raden-ayu44/embedded-systems/asumsi.md

# Asumsi — Gambar Skematik Housing Grip Load Cell (v5, varian logam)

Dikerjakan satu kali, langsung dari v4 ke v5. Sumber yang dipakai:
- `koreksi_v4.md` (utama);
- bagian `koreksi_v3.md` yang tidak digantikan (spacer PLA terpisah, pelat polos, urutan exploded, kesalahan yang pernah terjadi);
- instruksi pengguna di chat;
- gambar penjual Automa-88 "Loadcell CZL-601, Size & Dimensions", disimpan sebagai `czl601_dimensi_automa88.png`.

Berkas v4 tidak ditimpa. Semua gambar **tidak berskala**, dan celah 2,5 mm digambar diperbesar.

**Pembaruan 11 Okt. 2026 (hanya teks dokumen ini):** hasil ukur load cell (130 × 28 × 21,5 mm), ulir lubang pasang (M6, tembus, bibir kisi Ø8 mm), dan diameter kabel (4 mm) sudah dimasukkan. Ringkasan di Bagian 8. **Gambar SVG v5 belum digambar ulang** dan masih memuat label lama (misalnya kabel Ø5, tinggi load cell 22).

**Pembaruan 12 Okt. 2026 (hanya teks dokumen ini):** gambar yang berlaku sekarang bukan lagi v5, melainkan:
- `potongan_memanjang_v11_logam.svg` dan `kalibrasi_setup_v11_20kg.svg`;
- `exploded_isometrik_v12_logam.svg` (panah stiker beban menunjuk ke arah B; lihat 4.1 dan `koreksi.md`);
- `klem_kabel_tampak_depan_v1.svg` dan `klem_kabel_tampak_kiri_v1.svg` (tampak depan dan potongan A-A di x = 4,2 untuk klem kabel; instruksinya `instruksi_klem_tampak.md`);
- `fusion_parameters_housing_grip.csv` (tidak ada CSV v9 sampai v12).

Berkas v5 di tabel di bawah hanya riwayat. Dokumen ini adalah gabungan: isi asumsi lama (v2, v3, dan v4) sudah dipadatkan ke Bagian 9 dan berkas lama itu dihapus (12 Okt. 2026). Instruksi untuk Cowork ada di `koreksi.md` (juga gabungan). Arah kabel, panah stiker, dan rincian klem di Bagian 4.1 sudah mengikuti gambar-gambar di atas.

| File v5 | Isi |
|---|---|
| `potongan_memanjang_v5_logam.svg` | Potongan memanjang melalui satu baris lubang. Pelat Al 10 polos, Spacer A/B PLA, load cell 130 mm, baut M6 × 25 + washer. Dimensi a = 37, x = 102, spacer 28, bentang bebas 74, lubang 12 dari ujung, 106 antar pasangan |
| `exploded_isometrik_v5_logam.svg` | Urutan dari atas: pelat A → Spacer A → load cell → Spacer B → pelat B. 4 baut pola 2 × 2 (15 melintang, 106 antar pasangan) |
| `kalibrasi_setup_v5.svg` | **Tidak dibuat**, sesuai permintaan (lihat Pertentangan 6) |

## 1. Perubahan dari v4

1. **Load cell diganti** dengan CZL601. Ukuran di gambar penjual 130 × 28 × 22 mm; **terukur 130 × 28 × 21,5 mm (10 Okt. 2026, jangka sorong)**. Ukuran lama 147 × 30 × 22 mm dari load cell 180 kg tidak dipakai lagi. Load cell ditaruh di tengah pelat 170 mm, jadi sisa pelat 20 mm di tiap ujung.
2. **Lubang pasang:** 4 × M6, dua per ujung. Pusat lubang 12 mm dari ujung load cell, 106 mm antar pasangan, dan 15 mm melintang (angka dari gambar penjual, belum diukur). Lubang pelat dan spacer sejajar dengan lubang load cell. Diameter lubang: **Ø6,6 mm di pelat** dan **Ø7,0 mm di spacer PLA** (keputusan 11 Okt. 2026; gambar SVG v5 belum memuat angka ini). **Ulir lubang di load cell terukur M6** (diameter dalam 5,0 dan 5,2 mm; bibir kisi Ø8 mm; tembus lurus), lihat Bagian 8.
3. **Tonjolan dihapus**, dan pelat A/B menjadi **pelat aluminium 10 mm polos** (sudah diputuskan; paduan **6061-T6**, alternatif 5052-H32, keputusan 11 Okt. 2026). Counterbore v4 juga dihapus, karena pelat polos tidak difrais.
4. **Spacer PLA terpisah:**
   - Spacer A dan Spacer B, masing-masing 28 × 28 × 2,5 mm, menutup kedua lubang di ujungnya.
   - Callout 4 = Spacer A, callout 5 = Spacer B. Nomor callout lain tetap. Arsirannya dibedakan dari aluminium dan load cell.
5. **Baut:** M6 × 25 + washer logam, 4 buah, langsung masuk ulir load cell tanpa mur. Kepala dan washer menonjol di luar pelat (lihat 3.3).
6. **Geometri turunan (boss_L = 28):** lengan tuas a = 37 mm, ujung jauh x = 102 mm, bentang bebas 74 mm. Nilai lama 60/133 (v4) dan 43,5/117/30/87 (`koreksi_v3.md`) tidak dipakai.
7. **Zona genggam ≈85 mm**, sebelumnya ≈90 di v4. Zona ini lebih panjang daripada bentang bebas 74 mm, jadi sebagian beban jatuh di atas spacer. Model beban terpusat di tengah tetap dipakai dan konservatif untuk momen.
8. **Area tengah load cell** yang berarsir di gambar penjual digambar sebagai area tengah/penutup sebagai area tengah/penutup (callout 17). Tinggi penutup di atas permukaan diasumsikan 1,0 mm (asumsi desain, 11 Okt. 2026; ukur pada load cell sungguhan).
9. **Lubang binokular** digambar sebagai dua lubang bulat yang disambung celah, mengikuti bentuk di gambar penjual. Ukurannya skematik, tanpa angka.
10. **Kabel:** panjang kabel CZL601 belum diketahui, jadi gambar dan legenda tidak memuat angka panjang kabel. Keputusan 11 Okt. 2026: panjang kabel dipakai ≈28 cm (listing penjual; asumsi desain), lihat 4.1.
11. **Tetap sama:** celah 2,5 mm sebagai celah bebas-sentuh, tebal total 51,5 mm, ridge dan bidang tumpu di sisi luar B, klip kabel menyatu dengan Spacer A, arah beban remasan, jalur gaya tunggal, dan catatan "Stop overload belum dirancang".
12. **Diameter kabel load cell = 4 mm (dilaporkan pengguna, 11 Okt. 2026)**, menggantikan asumsi kerja 5 mm di revisi v5 sebelumnya. Cocok dengan dokumen distributor (4 mm). Yang terdampak (rincian di bagian 4.1):
    - penjepit kabel di batang A: lubang ≈ Ø kabel (4 mm), lebar dan tinggi penjepit menyesuaikan;
    - lengkungan sisa kabel di dekat penjepit: radius tekuk 10 mm (asumsi desain, revisi 11 Okt. malam, lihat 4.1);
    - tempat kabel keluar dari ujung load cell ke penjepit.

    ⚠ Gambar SVG v5 masih berlabel "kabel Ø5 (asumsi kerja, belum diukur)" dan penjepit ≈9 mm. Keduanya belum diperbarui. Angka lain tidak berubah.

## 2. Hitungan kekakuan

### Model
- **Model:** sama dengan model v4 (lihat Bagian 9). Kantilever, F = 686 N (70 kgf), lebar pelat b = 30 mm, I = b·h³/12, E aluminium 70 GPa.
- **Beban:** terpusat di tengah load cell.
- **Geometri:** a = 130/2 − boss_L, x = 130 − boss_L.
- **Rumus:**
  - δ(a) = F·a³ / (3EI)
  - δ(x) = F·a²(3x − a) / (6EI)
  - σ = F·a·(h/2) / I
  - σ_net = σ·b / (b − 2d)
- **Keterbatasan:**
  - Spacer dan baut dianggap kaku.
  - Lenturan load cell sendiri, tinggi penutup, dan margin rakit tidak termasuk.
  - σ_net konservatif, karena lubang berada 16 mm di dalam spacer (12 mm dari ujung), bukan di tepi dalam spacer tempat momen terbesar.
  - Ini hitungan kasar untuk arah desain, bukan verifikasi.

### 2.1 Hasil (dihitung ulang) dan perbandingan dengan tabel `koreksi_v4.md` bagian E

| Pelat | boss_L | a / x | δ titik beban | δ ujung jauh | Sisa celah 2,5* | σ pangkal | σ_net Ø5,5 / Ø6,5 |
|---|---|---|---|---|---|---|---|
| **Al 10 mm (digambar)** | **28** | **37 / 102** | **0,066 mm** | **0,241 mm** | **≥ 2,26 mm** | **50,8 MPa** | **80 / 90 MPa** |
| Al 8 mm (pembanding) | 28 | 37 / 102 | 0,129 mm | 0,470 mm | ≥ 2,03 mm | 79,3 MPa | 125 / 140 MPa |
| Al 10 mm | 24 | 41 / 106 | 0,090 mm | 0,304 mm | ≥ 2,20 mm | 56,3 MPa | 89 / 99 MPa |
| Al 8 mm (pembanding) | 24 | 41 / 106 | 0,176 mm | 0,594 mm | ≥ 1,91 mm | 87,9 MPa | 139 / 155 MPa |

\* Sisa celah = 2,5 mm dikurangi lenturan ujung jauh saja.

Aluminium 8 mm hanya pembanding dan tidak digambar.

**Selisih lebih dari 2% terhadap tabel acuan:**

| Sel | Acuan | Hitungan ini | Selisih | Sebab |
|---|---|---|---|---|
| Al 10 / boss 28, δ titik beban | 0,07 mm | 0,066 mm | −5,4% | **Pembulatan.** 0,0662 dibulatkan ke 2 desimal menjadi 0,07. Dengan 3 desimal nilainya 0,066. Tidak ada beda model. |
| Al 8 / boss 24, δ titik beban | 0,16 mm | 0,176 mm | +9,9% | **Nilai acuan tidak konsisten**, bukan pembulatan. Dengan a dan E yang sama, rasio Al 8 terhadap Al 10 harus (10/8)³ = 1,95. Hitungannya 0,090 × 1,95 = 0,176. Nilai 0,16 hanya keluar bila a ≈ 39,7 mm. Kemungkinan salah hitung atau salah ketik di acuan. Kolom lain di baris yang sama (δ ujung jauh 0,59, σ 88) cocok dengan a = 41. |

Semua sel lain berselisih ≤ 1,4%. Tabel lama di `koreksi_v3.md` (a = 43,5, x = 117) sudah digantikan dan tidak dipakai.

### 2.2 Apakah celah 2,5 mm terlampaui di bawah beban?
- **Al 10 mm (digambar):** lenturan ujung jauh 0,24 mm (boss 28) sampai 0,30 mm (boss 24). **Celah tidak terlampaui** oleh lenturan pelat. Setelah anggaran celah 2.3, sisa celah ≈0,46 mm (boss 28) dan ≈0,40 mm (boss 24).
- **Dibanding v4:** lenturan ujung jauh turun dari 0,80 mm menjadi 0,24 mm. Penyebabnya, a turun dari 60 ke 37 mm berkat spacer 28 mm, padahal v4 memakai tonjolan ≈13,5 mm dengan load cell 147 mm.

### 2.3 Anggaran celah (Al 10, boss 28)

| Komponen | Nilai |
|---|---|
| Lenturan ujung jauh pelat | 0,24 mm |
| Lenturan load cell sendiri pada 70 kgf | 0,5 mm (asumsi desain; belum diukur) |
| Tinggi penutup/area tengah di atas permukaan | 1,0 mm (asumsi desain) |
| Margin rakit (kerataan pelat, spacer, baut) | 0,3 mm (asumsi desain) |
| **Total terpakai** | **2,04 mm** |
| **Sisa dari celah 2,5 mm** | **≈0,46 mm** (boss 24: lenturan 0,30, sisa ≈0,40 mm) |

### 2.4 Catatan Ø lubang
Keputusan 11 Okt. 2026: **lubang pelat Ø6,6 mm** (lubang lewat M6 seri sedang, ISO 273) dan **lubang spacer Ø7,0 mm** (Ø pelat + 0,4). Kasus Ø5,5 dihitung sesuai instruksi awal, tetapi **tidak mungkin dipakai sebagai lubang lewat baut M6**, karena diameter nominal ulir M6 = 6 mm. Kasus Ø6,5 lebih realistis. Sebagai pembanding, lubang lewat M6 menurut ISO 273 biasanya 6,4 / 6,6 / 7,0 mm. Dengan Ø6,6, σ_net Al 10 / boss 28 ≈ 91 MPa (Al 8 / boss 28 ≈ 142 MPa; Al 10 / boss 24 ≈ 101 MPa; Al 8 / boss 24 ≈ 157 MPa). Paduan 6061-T6 punya luluh minimum ≈240 MPa, jadi faktor keamanan ≈2,6 (91 MPa) dan ≈2,4 (101 MPa). Ø lubang pelat **6,6 mm**, ulir load cell terukur M6.

## 3. Pemeriksaan spacer PLA dan baut

### 3.1 Kompresi spacer (E PLA ≈3 GPa, F = 686 N, tebal 2,5 mm)

| Kasus | Luas bersih | Kompresi | Tekanan rata-rata |
|---|---|---|---|
| Geometri v5: 28 × 28, **2 lubang** Ø6,5 per spacer | 717,6 mm² | 0,0008 mm | 0,96 MPa |
| Sesuai teks instruksi: 28 × 28, 4 lubang Ø6,5 | 651,3 mm² | 0,0009 mm | 1,05 MPa |
| Lama (`koreksi_v3.md`): 30 × 30, 4 lubang | 767 mm² | 0,0007 mm (dibulatkan "≈0,001") | — |

Kompresi spacer dapat diabaikan terhadap celah 2,5 mm di semua kasus. Tiap spacer hanya menutup dua lubang (lihat Pertentangan 4).

### 3.2 Tekanan tepi spacer
- **Metode lama** (seluruh momen ditahan kontak spacer, penampang utuh, tanpa preload):
  - M = F·a = 686 × 37 = 25 382 N·mm.
  - S = 28·28²/6 = 3 659 mm³.
  - **M/S ≈ 6,9 MPa** (lama 6,6 MPa dengan a = 43,5 dan spacer 30 × 30).
  - Ditambah tekanan rata-rata ≈1 MPa, tekanan tepi maksimum **≈7,9 MPa**.
- ⚠ **Keterbatasan metode itu:** baut hanya ada 12 mm dari ujung, yaitu 16 mm dari tepi dalam spacer. Tanpa preload yang cukup, pelat cenderung berungkit di tepi dalam spacer:
  - tarik baut per ujung ≈ F·a / 16 ≈ 1,6 kN (≈0,8 kN per baut);
  - gaya kontak di tepi dalam ≈ F·(a + 16) / 16 ≈ 2,3 kN, terpusat di dekat tepi;
  - tekanan lokalnya bergantung pada lebar kontak (asumsi kerja ≈5 mm, jadi ≈2,3 kN / (28 × 5) ≈ 16 MPa) dan bisa jauh di atas 7,9 MPa. Preload baut menahan ini (lihat di bawah).
- **Kesimpulan 3.2:** angka 6,9–7,9 MPa hanya berlaku bila preload baut cukup untuk menjaga seluruh permukaan spacer tetap tertekan. Torsi baut **3 N·m** (asumsi desain, di bawah batas baut kelas 8.8) → preload T = K·d·F dengan K = 0,2, jadi F ≈ 3 / (0,2 × 0,006) ≈ **2,5 kN per baut**. Tekanan rata-rata spacer ≈7 MPa dan tepi ≈14 MPa, di bawah kisaran tekan PLA ≈50 MPa tetapi rawan creep.
- **Risiko PLA:** creep/relaksasi preload. Washer logam di bawah kepala baut mengurangi tekanan di bawah kepala. Washer tidak mencegah creep spacer itu sendiri, jadi perlu cek ulang torsi setelah beberapa kali pakai (prosedur: kencangkan ulang 3 N·m sebelum tiap sesi kalibrasi dan setelah 10 sesi; beri tanda cat pada kepala baut untuk melihat bila longgar).

### 3.3 Panjang baut M6 × 25
- **Panjang ulir masuk:** 25 − washer (1,6 mm, ISO 7089 untuk M6) − pelat 10 − spacer 2,5 ≈ **10,9 mm**.
- **Ujung baut tidak menembus** permukaan seberang load cell (tinggi terukur 21,5 mm).
- **Lubang tembus** (diukur 11 Okt. 2026: berulir, tembus lurus), jadi baut tidak mentok di dasar lubang. Kedalaman ulir efektif sama dengan tinggi load cell.
- **Kecukupan ulir:** ≈10,9 mm ≈ 1,8 × d. Ulir ada sepanjang 21,5 mm, jadi masuk 10,9 mm masih jauh di bawah panjang ulir yang tersedia.
- **Kepala baut dan washer** menonjol di luar pelat A (ujung tetap) dan pelat B (ujung bebas), 32 mm dari ujung pelat. Posisinya **di luar zona genggam** (42,5–127,5 mm). Ketebalan lokal di ujung bertambah setinggi washer + kepala (baut kepala segi enam ISO 4017 M6 × 25 kelas 8.8 dengan washer ISO 7089; tonjolan ≈5,6 mm). Tebal total pelat–load cell = 10 + 2,5 + 21,5 + 2,5 + 10 + ridge 5 = 51,5 mm (Al 8 mm ≈ 47,5 mm); kepala baut belum termasuk.

### 3.4 Lebar dan panjang spacer
- **Lebar:** spacer 28 mm. Lebar load cell terukur 28 mm (10 Okt. 2026), jadi spacer selaras dengan lebar load cell. (Sebelumnya, bila load cell 30 mm, spacer lebih sempit 1 mm per sisi, tetapi tetap menutup kedua lubang: pusat ±7,5 mm + jari-jari 3,3 mm = 10,8 mm < 14 mm.)
- **Panjang:** spacer 28 mm tidak boleh melewati blok ujung ke area tengah. Panjang blok ujung ≈27–28 mm hanya taksiran dari skala gambar penjual, jadi **ukur**. Bila blok hanya 27 mm, spacer 28 mm menumpang 1 mm di area tengah. Kasus boss_L = 24 mm sudah dihitung dan tetap lolos (2.1).

## 4. Catatan lain
- **Kapasitas load cell:** judul `koreksi_v4.md` menyebut CZL601 **80 kg**, sehingga 70 kgf (batas atas S1) = **87,5% dari kapasitas**.
  - Spesifikasi lama (2,0 mV/V, safe overload 150%, panjang kabel, dan seterusnya) milik load cell 180 kg dan **tidak berlaku lagi**. Nilai desain dari datasheet DS-LC1: overload aman 120% (96 kgf) dan merusak 150% (120 kgf).
  - Karena stop overload belum dirancang, remasan di atas ≈80 kg tidak terlindungi. Ini perlu dipertimbangkan bersama batas overload dari datasheet.
- **Massa B:** pelat B Al 10 mm ≈138 g di ujung bebas, jauh di atas tolerance ±36 g di S1. Tare dan pengukuran harus dilakukan pada orientasi yang sama.
- **Grip hibrida:** pelat logam (potong dan bor di bengkel) + spacer dan penjepit PLA. Baut tidak masuk ke PLA, tetapi menembus spacer PLA yang ikut terjepit.

### 4.1 Kabel: diameter 4 mm (dilaporkan pengguna, 11 Okt. 2026)
- **Diameter kabel:** 4 mm, menggantikan asumsi kerja 5 mm dari revisi v5 sebelumnya. Cocok dengan dokumen distributor (4 mm). Alat ukur dan jumlah pengukuran tidak dicatat; ukur ulang dengan jangka sorong bila perlu.
- **Klip kabel (revisi 11 Okt. malam: menyatu dengan Spacer A):**
  - Klip tidak lagi ditempel ke pelat aluminium. Spacer A dicetak satu bagian dengan rak 2,5 mm (≈16 mm sepanjang batang, menjulur 10 mm melewati sisi load cell, ≈9 mm melewati tepi pelat A) dan blok penjepit; semuanya terjepit oleh baut (asumsi desain).
  - Blok: lebar 8,2 mm (sepanjang batang), tebal 8 mm ke arah luar (mulai 1 mm dari sisi load cell), tinggi ≈17,4 mm dari permukaan pelat A. Lubang kabel **Ø4,1 mm** (Ø kabel + 0,1), sumbu 13,25 mm di atas permukaan A dan 4,2 mm dari ujung load cell, segaris dengan lubang Ø5 di load cell. Dinding ≈2,05 mm di kiri dan kanan lubang.
  - **Dinding atas dan bawah lubang (12 Okt. 2026, dari potongan A-A di x = 4,2):** 2,1 mm ke arah B (17,4 − 13,25 − 2,05) dan 11,2 mm ke arah A (13,25 − 2,05, diukur dari muka pelat A, termasuk rak 2,5). Tampak depan dan tampak kiri: `klem_kabel_tampak_depan_v1.svg` dan `klem_kabel_tampak_kiri_v1.svg`.
  - Kabel direkat **lem tembak** di lubang. Epoksi tidak dipakai (tidak tersedia), dan pengikat kabel dibatalkan. Celah kabel Ø4 ke lubang Ø5 load cell = 0,5 mm per sisi.
  - Jarak bebas blok ke pelat B ≈9 mm (26,5 − 17,4 = 9,1). Blok 20–28 mm dari ujung pelat, di luar zona genggam (mulai 42,5 mm). Bagian sisi A saja.
- **Tempat kabel keluar (terukur 11 Okt. 2026, menggantikan asumsi muka ujung):**
  - Kabel keluar **menyamping** dari muka samping panjang load cell (130 × 21,5 mm), di dekat ujung berkabel, di tengah tinggi (10,75 mm dari muka atas dan bawah, jadi 13,25 mm di atas permukaan pelat A).
  - Lubang kabel Ø5 mm; kabel Ø4 mm agak longgar. Tepi lubang ke arah tengah 6,7 mm dari ujung load cell, jadi pusat lubang 4,2 mm dari ujung dan dinding ke muka ujung 1,7 mm. Titik keluar 24,2 mm dari ujung pelat, di luar zona genggam (mulai 42,5 mm).
  - **Kedalaman lubang Ø5 ke arah dalam ≈14 mm (asumsi, belum terukur;** nilai sementara LC_W / 2 di Fusion dan di tampak kiri; ukur dengan batang kawat atau kedalaman jangka sorong).
  - Ø4 mm lebih besar daripada celah 2,5 mm, tetapi kabel keluar di tengah tinggi di antara kedua pelat dan di samping spacer, jadi tidak lewat celah A–LC atau B–LC.
  - Ujung berkabel dijadikan ujung tetap (A).
  - **Panah beban di muka ujung bebas menunjuk ke arah B** (searah tebal 21,5, dengan A di atas), sesuai stiker pada benda asli (dikoreksi pengguna 12 Okt. 2026; digambar di `exploded_isometrik_v12_logam.svg`). Gaya tekan sebenarnya (B menekan ke arah A) berlawanan dengan panah, jadi pembacaan bertanda negatif bila skala tidak dibalik. Protokol kalibrasi sudah mengizinkan kemiringan skala negatif; tandanya diatur di firmware. Arah panah pada benda nyata masih perlu dicek ulang.
- **Lengkungan kabel setelah blok (asumsi desain):**
  - Kabel keluar lurus menyamping dari lubang Ø5 lewat blok, lalu melengkung bebas **ke arah B (ke bawah bila A di atas), menjauhi telapak**, dengan radius **10 mm** (2,5 × diameter; asumsi untuk kabel statis, cek pada kabel sungguhan). Lengkung 90° ke ujung pelat (revisi sebelumnya) dan radius 20 mm dibatalkan.
  - Titik lemah: rak PLA menjulur melewati tepi pelat (kantilever). Tarikan kabel kecil, tetapi bila rak melentur, lebarkan rak sepanjang batang.
- **Arah kabel pada posisi pakai (12 Okt. 2026, protokol V1: duduk, bahu netral, siku 90°, pergelangan 0-30°):** tangan kanan menggenggam, telapak di atas A, jari menekan B ke arah A. Lubang dan kabel di muka depan; lengkung bebas **ke arah B**, menggantung ke bawah menuju housing LCD di tangan kiri, tidak melintas di atas telapak (asumsi; orientasi tangan terhadap batang belum diverifikasi pada benda nyata). Sama dengan model CAD pemilik proyek. Kabel hanya terpasang lurus di lubang blok, jadi arah lengkung hanyalah rute. Pada setup kalibrasi (rakitan dibalik) kabel diarahkan turun ke alas karet, yaitu ke arah A, supaya tidak naik ke ruang di bawah papan. Ini menggantikan arah "ke arah A" di `koreksi_v9.md` C.3 dan `koreksi_v10.md`.
- **Panjang kabel:** dipakai ≈28 cm (listing penjual; dokumen distributor menulis 0,42 m; asumsi desain). Sisa jangkauan dari blok ≈27 cm. Housing elektronik harus berada dalam jangkauan ini. Kabel sambungan di luar lingkup dokumen ini.

## 5. Pertentangan dan cara penyelesaiannya
Aturan: ikuti instruksi yang lebih spesifik.

1. **Ukuran spacer dan geometri.** `koreksi_v3.md`: spacer 30 × 30, a = 43,5, x = 117, bentang 87. `koreksi_v4.md`: 28 × 28, a = 37, x = 102, bentang 74. → **Ikut `koreksi_v4.md`** (menggantikan v3 secara eksplisit, dan memakai ukuran load cell yang berlaku).
2. **Posisi lubang.** `koreksi_v3.md`: "posisi lubang TBD, jangan menulis angka koordinat". `koreksi_v4.md` dan instruksi pengguna: 12 dari ujung, 106 antar pasangan, 15 melintang. → **Angka ditulis.** Sumbernya gambar penjual dan instruksinya lebih spesifik. Diameter diputuskan 11 Okt. 2026: Ø6,6 pelat, Ø7,0 spacer.
3. **Jumlah lubang.** `koreksi_v3.md`: "pola lubang 2 × 2 per ujung" (8 lubang). `koreksi_v4.md` dan pengguna: 4 × M6, dua per ujung. → **4 lubang.**
4. **Luas bersih spacer.** `koreksi_v4.md` E: "28 × 28 setelah empat lubang". Menurut geometri, tiap spacer hanya menutup dua lubang di ujungnya. → **Hitungan utama memakai 2 lubang**, dan nilai 4 lubang ditampilkan sebagai pembanding (3.1).
5. **Tabel acuan `koreksi_v4.md` E:** dua sel berbeda > 2% (lihat 2.1). Satu karena pembulatan, satu karena acuan tidak konsisten (Al 8 / boss 24, δ titik beban 0,16 → 0,176). Angka tidak disamakan.
6. **Setup kalibrasi.** `koreksi_v3.md` F.1 meminta `kalibrasi_setup_v5.svg`, `koreksi_v4.md` D meminta bertanya dulu, dan pengguna meminta jangan dibuat. → **Tidak dibuat.** Setup kalibrasi yang berlaku sekarang adalah protokol dumbbell (`kalibrasi_protokol.svg`), menurut `koreksi_v4.md`.
7. **Zona genggam.** v4 ≈90 mm, sedangkan `koreksi_v3.md` dan `koreksi_v4.md` menyebut ≈85 mm. → **85 mm.**
8. **Kasus Ø5,5.** Diminta sebagai kasus hitungan, tetapi tidak cocok untuk baut M6 (2.4). → Dihitung dan diberi tanda, tidak dihapus.
9. **"Stop overload".** Frasa ini muncul tepat satu kali di tiap SVG v5, sebagai catatan "Stop overload belum dirancang".
10. **Ujung tetap/bebas fisik belum ditentukan** (saat itu), padahal gambar butuh satu ujung tetap. → Ujung tetap digambar di kiri sebagai konvensi gambar. Ujung fisik load cell (termasuk ujung kabel) yang dijadikan ujung tetap: ujung berkabel (keputusan 11 Okt. 2026). Desain mengharuskan kabel keluar di ujung tetap.

## 6. Keputusan terbuka dan nilai yang masih asumsi
Tidak ada lagi butir yang belum ditentukan. Nilai yang **diukur**: lebar 28 mm, tinggi 21,5 mm, ulir M6 tembus dari kedua sisi, minor 5,0–5,2 mm, Ø kabel 4 mm. Nilai dari **standar atau datasheet**: lubang lewat M6 6,6 mm (ISO 273), washer 1,6 mm (ISO 7089), overload 96/120 kgf (DS-LC1). Nilai **asumsi desain** (11–12 Okt. 2026) yang perlu dicek pada benda nyata:
- jarak lubang 12 / 106 / 15 mm (masih dari gambar penjual);
- panjang kabel ≈28 cm, lubang kabel Ø5 mm di muka samping (terukur), **kedalaman lubang Ø5 ≈14 mm (asumsi, belum terukur)**, radius tekuk 10 mm, klip menyatu dengan Spacer A (rak ≈16 × 10 mm, blok 8,2 × 8 × ≈17,4 mm, Ø4,1 mm, kabel dilem tembak; tanpa lem ke aluminium);
- arah panah stiker beban pada benda nyata (digambar menunjuk ke arah B, dikoreksi pengguna 12 Okt. 2026);
- anggaran celah: load cell 0,5 mm, penutup 1,0 mm, margin 0,3 mm;
- torsi 3 N·m dan prosedur kencang ulang;
- ridge PLA 30 × 3 × 5 mm, dua buah, jarak 22 mm, ditempel; alas karet 6 mm dengan satu slot 29 × 14 mm di bawah kedua kepala baut;
- uji baut M6 dengan tangan (tanpa dipaksa) belum dilakukan.

## 7. Pengecekan sebelum selesai
1. **Teks:** kedua SVG v5 dirender di Chromium. Batas semua teks diukur otomatis: 0 tumpang tindih, 0 terpotong. Hasil render juga diperiksa visual.
2. **Bersentuhan:** di potongan, semua bentuk milik A (pelat, Spacer A, baut + washer, penjepit) dan milik B (pelat, Spacer B, baut + washer, ridge, bidang tumpu) dicek tidak bersentuhan pada geometri tanpa beban. Cek di bawah beban ada di bagian 2.2–2.3.
3. **Label dan frasa:** semua gambar bertanda "TIDAK BERSKALA". "Stop overload" muncul satu kali per SVG. Tidak ada eyelet.
4. **Berkas lama:** berkas v4 tidak diubah.
5. **Revisi kabel Ø5 (sebelumnya):** kedua SVG v5 dirender ulang dan dicek otomatis: 0 teks tumpang tindih, 0 terpotong. Hasil render juga diperiksa visual. A dan B tetap tidak bersentuhan pada geometri tanpa beban (penjepit kabel hanya terikat ke A). Tidak ada angka panjang kabel di gambar.
6. **Pembaruan 11 Okt. 2026:** hanya dokumen ini yang diubah. SVG v5 tidak digambar ulang, jadi label Ø5 dan tinggi 22 mm di gambar sudah usang terhadap dokumen ini.
7. **Pembaruan 12 Okt. 2026:** hanya dokumen ini dan `koreksi.md` (yang kini memuat gabungan semua instruksi Cowork) yang diubah. Dua gambar klem v1 dan exploded v12 dirender di Chromium: 0 teks tumpang tindih, 0 terpotong. Semua angka klem cocok dengan `fusion_parameters_housing_grip.csv` dan 4.1. Exploded v12 dibandingkan baris demi baris dengan v11; hanya judul, panah stiker, legenda 19, dan catatan stiker yang berbeda. Tiga gambar v11 (potongan, setup, exploded) tidak berubah dari salinan yang sudah diperiksa.

## 8. Pembaruan hasil ukur (11 Okt. 2026)

| Item | Sebelumnya | Sekarang | Sumber |
|---|---|---|---|
| Ukuran load cell | 130 × 28 × 22 mm (gambar penjual, belum diukur) | **130 × 28 × 21,5 mm** | Pengukuran 10 Okt. 2026 (Catatan Proyek §15, C1) |
| Lubang pasang: jenis | Ulir M6 (gambar penjual) | **Berulir, tembus lurus** | Dilaporkan pengguna |
| Lubang pasang: diameter dalam (minor) | belum diukur | **5,0 dan 5,2 mm** (dua pembacaan jangka sorong) → ulir **M6** (minor M6 ≈ 4,9–5,2 mm). M5 ≈ 4,2 dan M8 ≈ 6,7 tidak cocok | Dilaporkan pengguna; uji baut M6 dengan tangan belum dilakukan |
| Lubang pasang: bibir kisi (chamfer) | — | **Ø8 mm** (hanya mulut lubang, bukan ukuran baut) | Dilaporkan pengguna |
| Diameter kabel | 5 mm (asumsi kerja; distributor 4 mm) | **4 mm** | Dilaporkan pengguna |
| Lubang kabel di load cell | Muka ujung (asumsi) | **Muka samping panjang, tengah tinggi, Ø5 mm, pusat 4,2 mm dari ujung** (tepi ke arah tengah 6,7 mm; kabel Ø4 mm longgar) | Sketsa dan pengukuran pengguna, 11 Okt. 2026 |
| Panah beban | Belum diketahui (C5) | **Di muka ujung bebas, menunjuk ke arah B** (searah tebal 21,5). Semula tercatat "ke bawah"; arah dikoreksi pengguna 12 Okt. 2026, lihat 4.1 | Sketsa pengguna, 11 Okt. 2026; koreksi 12 Okt. 2026 |
| Baut M6 × 25 untuk grup | Tercantum di daftar kebutuhan komponen kelompok | Cocok dengan ulir M6 | — |

Dampak pada dokumen ini: 1 (butir 1, 2, 12), 3.3, 3.4, 4.1, dan 6. Jarak antar lubang dan jarak dari ujung (106 / 15 / 12 mm) belum diukur. Ulir M6 dengan tembus lurus berarti baut M6 × 25 tidak mentok di dasar lubang.

## 9. Riwayat versi sebelumnya (dipadatkan dari asumsi v2, v3, dan v4)
Berkas lama itu dihapus pada 12 Okt. 2026. Angka di tabel ini milik rancangan lama dan **tidak berlaku**; yang disimpan hanya keputusan dan alasannya.

| Versi | Rancangan | Keputusan dan temuan yang masih berguna |
|---|---|---|
| v2 (5 Okt.) | Batang PLA 7 mm, load cell 180 kg (147 × 30 × 22), A di bawah, celah ≈1,5 mm, tebal total ≈44 mm | Tiap batang bekerja sebagai kantilever ≈120 mm dan melentur puluhan mm (≈11 mm pada 200 N, ≈21 mm pada 400 N), jadi B menyentuh load cell dan PLA patah. Celah harus diukur dari titik tertinggi penutup putih, bukan permukaan logam. Posisi lubang, ulir, tembus/buta, arah beban, dan ujung kabel saat itu belum diketahui |
| v3 (5 Okt.) | Orientasi dibalik: A (telapak) di atas, B (jari) di bawah, ujung tetap di kiri; varian PLA (konsep awal, dengan peringatan kekakuan) dan varian logam (Al 8 mm / baja 6 mm) | Zona genggam ≈90 mm dan lengan tuas ≈60 mm (asumsi). PLA 7 mm: δ 19,2 mm dan σ 168 MPa pada L = 60, jauh di atas kekuatan PLA cetak (±30–50 MPa), patah sebelum 70 kgf. Al 8 mm: δ 0,55 mm, σ 129 MPa. Baja 6 mm: δ 0,46 mm, σ 229 MPa (mendekati luluh baja lunak ≈235 MPa). **Celah di ujung jauh lebih kritis daripada di titik beban** (pelat terus melentur melewati titik beban): Al 8 mm 1,56 mm di ujung load cell, melampaui celah 1,5 mm. Pengecekan geometri tanpa beban saja tidak cukup; wajib cek defleksi. Varian logam butuh akses bengkel, berat Al 8 mm ≈110 g per batang, baut tidak lagi masuk PLA. Ridge dan eyelet PLA tempel: kekuatan eyelet untuk kalibrasi gantung perlu dicek |
| v4 (6 Okt.) | Al 10 mm, celah 2,5 mm, tebal total ≈52 mm, load cell 147 mm | Eyelet dihapus, diganti bidang tumpu kalibrasi di antara dua ridge. Kata "stop overload" hanya dipakai sebagai catatan "belum dirancang" (celah hanya celah bebas-sentuh). Al 10 mm: δ titik beban 0,28 mm, δ ujung jauh 0,80 mm, σ 82 MPa, σ_net 130–145 MPa; Al 8 mm σ_net 203–227 MPa tidak lolos; baja 8 mm σ_net 227 MPa ≈97% luluh. Tebal ≈52 mm melampaui anggaran awal 40–48 mm (cek kenyamanan dengan prototipe kardus). Massa B ≈138 g jauh di atas tolerance S1, jadi tare dan pengukuran harus pada orientasi yang sama. Kalibrasi dengan rakitan dibalik (A di bawah, B di atas, beban menekan B ke A) karena beban yang digantung menarik B menjauhi A, kebalikan remasan |

Keterbatasan setup kalibrasi lama yang masih relevan: bidang tumpu di antara dua ridge hanya ≈22 mm, jadi alas beban harus muat atau perlu adaptor; saat A ditumpu meja, lenturan A saat digenggam tidak teruji, hanya celah sisi B yang teruji pada beban tinggi.
