raden-ayu44/embedded-systems/videos/README.md

# Videos

Demo recordings, click a thumbnail to watch.

---

### Walking Light

walking-light (https://youtu.be/m1M6UbQBvOE?si=FuMw_M8vHzKiaSZN)

---

### Bidirectional Light

bidirectional-light (https://youtu.be/MZhPme2jAbs?si=ehmW6Z97izU37Ht1)

---

### Blocking Dual Blink

blocking-dual-blink (https://youtu.be/p5EK-iqPG1Y?si=7OF5Av_De61gU-On)

---

### Non-blocking Dual Blink

non-blocking-dual-blink (https://youtu.be/Jmo6wqRpATs?si=LPcUgDtTLZjZAEZN)

---

### Hardware Timer

hardware-timer (https://youtu.be/VnZXU5EmQIg?si=Lhj6Wf65bhTsT74y)

---
