raden-ayu44/embedded-systems/finpro/pcb/pcb_v1_netlist.xlsx

Sheet: Netlist
Net | Fungsi | Pin | Jumlah pin
BTN | Tombol, GPIO25 (pull-up internal, interrupt) | J1.8 (GPIO25), SW1.4 | 2
LED_DRV | Keluaran GPIO27 ke resistor | J1.10 (GPIO27), R1.1 | 2
GND | Ground bersama (pour tembaga sisi bawah) | J1.14 (GND), J2.14 (GND), SW1.1, D1.K, J3.1, J4.1, C1.2, C2.-, TP1.2 | 9
I2C_SCL | LCD SCL, GPIO22 | J2.2 (GPIO22), J4.4 | 2
I2C_SDA | LCD SDA, GPIO21 | J2.5 (GPIO21), J4.3 | 2
HX_SCK | HX711 SCK, GPIO19 | J2.6 (GPIO19), J3.3 | 2
HX_DT | HX711 DOUT, GPIO18 | J2.7 (GPIO18), J3.2 | 2
+3V3 | Rail logika 3,3 V dari regulator papan ESP32 | J2.15 (3V3), J3.4, J4.2, C1.1, C2.+, TP1.1 | 6
LED_A | Resistor ke anoda LED | R1.2, D1.A | 2
(tidak dipakai) | VIN (J1.15) dibiarkan terbuka: papan dicatu dari USB | J1.15 (VIN) | 1

Sheet: Komponen
Ref | Komponen | Jumlah | Fungsi | Catatan / status
J1 | Soket betina 1x15, pitch 2,54 | 1 | Header kiri DevKit V1 (EN ... VIN). Baris atas PCB (y=0) | Standar; lubang bor 1,0 mm, pad 1,7 mm
J2 | Soket betina 1x15, pitch 2,54 | 1 | Header kanan DevKit V1 (GPIO23 ... 3V3). Baris bawah (y=25,4) | Jarak antar baris J1-J2 = 25,4 mm (ukur 25,3)
J3 | Header pin jantan 1x4, 2,54 | 1 | Ke modul HX711 (GND, DT, SCK, VCC) lewat kabel jumper | Urutan pin modul XFW-HX711 belum dicek; kabel jumper mengatasinya
J4 | Header pin jantan 1x4, 2,54 | 1 | Ke backpack I2C LCD (GND, VCC, SDA, SCL) lewat kabel jumper | Urutan backpack umum GND-VCC-SDA-SCL; cek saat barang tiba
SW1 | Tombol tactile 6x6 mm | 1 | Tombol tunggal (START/NEXT/RESTART), GPIO25 | Footprint sementara; hanya dua kaki diagonal dipakai. Ganti sesuai DS-BTN1
D1 | LED 5 mm | 1 | Indikator genggam, GPIO27 | Warna dan Vf belum diketahui
R1 | Resistor 100 ohm | 1 | Pembatas arus LED | Dipilih untuk sekitar 13 mA dengan Vf 2,0 V (anggaran daya mencatat 15 mA); cek Vf LED
C1 | Kapasitor keramik 100 nF | 1 | Decoupling dekat J3 (catu HX711) | Opsional; dari komponen lab
C2 | Kapasitor elektrolit 10 uF, 6,3 V atau lebih | 1 | Decoupling dekat J3 | Opsional; perhatikan polaritas (+ ke 3V3)
TP1 | Header pin jantan 1x2 | 1 | Titik uji 3V3 dan GND untuk multimeter | Opsional
H1-H4 | Lubang M3, 3,2 mm | 4 | Pemasangan ke housing | Posisi (3,-11), (43,-11), (3,44), (43,44)

Sheet: Asumsi dan sisa
No | Asumsi / sisa | Catatan
1 | Pin DevKit simetris: 7,97 mm dari tiap ujung papan ke pin pertama dan terakhir | Belum diukur. Ukur jarak ujung USB ke pusat pin VIN/3V3 dan ujung antena ke pusat pin EN/GPIO23. Geser soket bila beda lebih dari 0,5 mm
2 | Jarak antar baris 25,4 mm (hasil ukur 25,3 mm) | Selisih 0,1 mm masih di dalam kelonggaran pin 0,5 mm di lubang 1,0 mm
3 | Ujung USB rata dengan tepi kiri PCB; antena menjorok 5,5 mm melewati tepi kanan | Konektor USB tidak menonjol (ukuran pengguna); area antena modul 6,19 mm harus bebas tembaga
4 | Tinggi: bagian papan setinggi 6,6 mm di atas bibir soket | Dari ukuran pengguna; tinggi soket belum dipilih
5 | LCD dan HX711 dicatu dari 3V3 | Mengikuti catatan proyek. Backpack I2C punya pull-up ke VCC: jangan dicatu 5 V karena SDA dan SCL akan tertarik ke 5 V (ESP32 hanya 3,3 V). Eksitasi load cell pada catu 3,3 V lebih rendah dari 4,3 V pada 5 V; perlu dicek lewat uji
6 | VIN tidak dipakai | Papan dicatu dari USB; jangan menyambung catu luar ke VIN bersamaan dengan USB
7 | Tidak ada proteksi polaritas, sekering, atau pelindung ESD | Cukup untuk draf non formal; tinjau bila diminta kelas
8 | Pemberian jalur belum dilakukan | Usul: dua lapis, GND pour di sisi bawah, jalur sinyal 0,3 mm, jalur 3V3 0,5 mm, jarak minimum 0,25 mm. Sesuaikan dengan aturan kelas dan kemampuan pabrik (DS-MFG1)
9 | Persyaratan tugas PCB (alat desain, ukuran maksimum, aturan) belum diketahui | Menunggu materi di EMAS
10 | Alokasi pin mengikuti tabel pin proyek: HX711 DT 18, SCK 19, LCD SDA 21, SCL 22, tombol 25, LED 27 | Dari catatan proyek (Bagian 13.7). Urutan header DevKit V1 dari gambar pinout yang dikirim
