raden-ayu44/embedded-systems/docs/w2/bidirectional-light-wiring.png

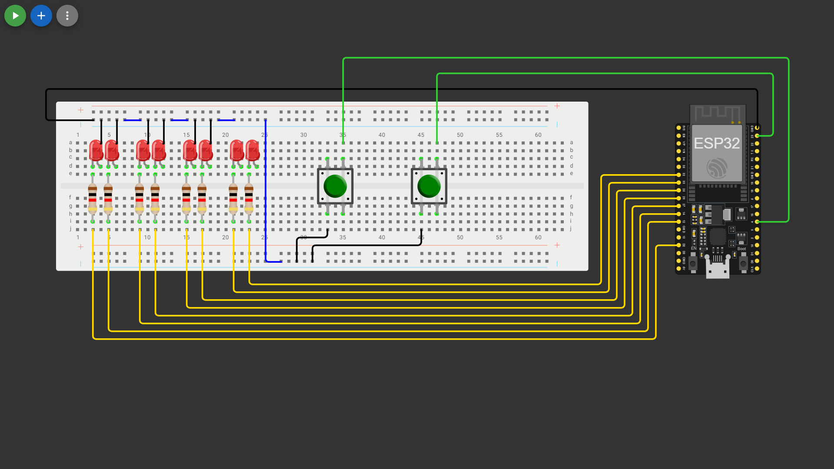
docs/w2/bidirectional-light-wiring.png
