raden-ayu44/embedded-systems/docs/w2/walking-light-wiring.png

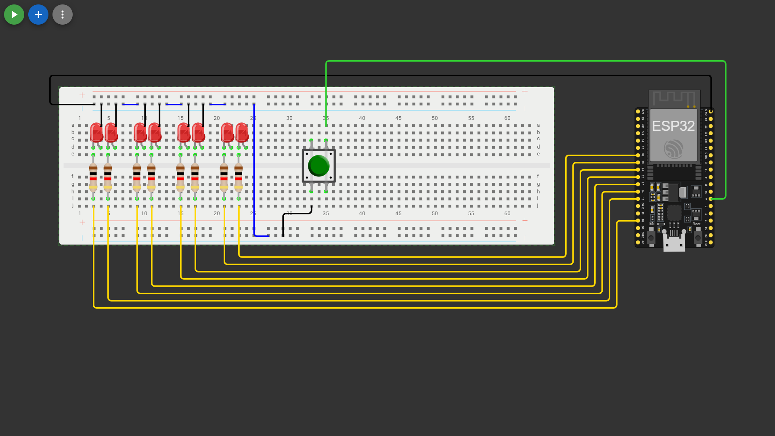
docs/w2/walking-light-wiring.png
