raden-ayu44/embedded-systems/pcb_penempatan.pdf

# PCB v1 pembawa ESP32 DevKit V1: penempatan (draf), diperbesar 3x

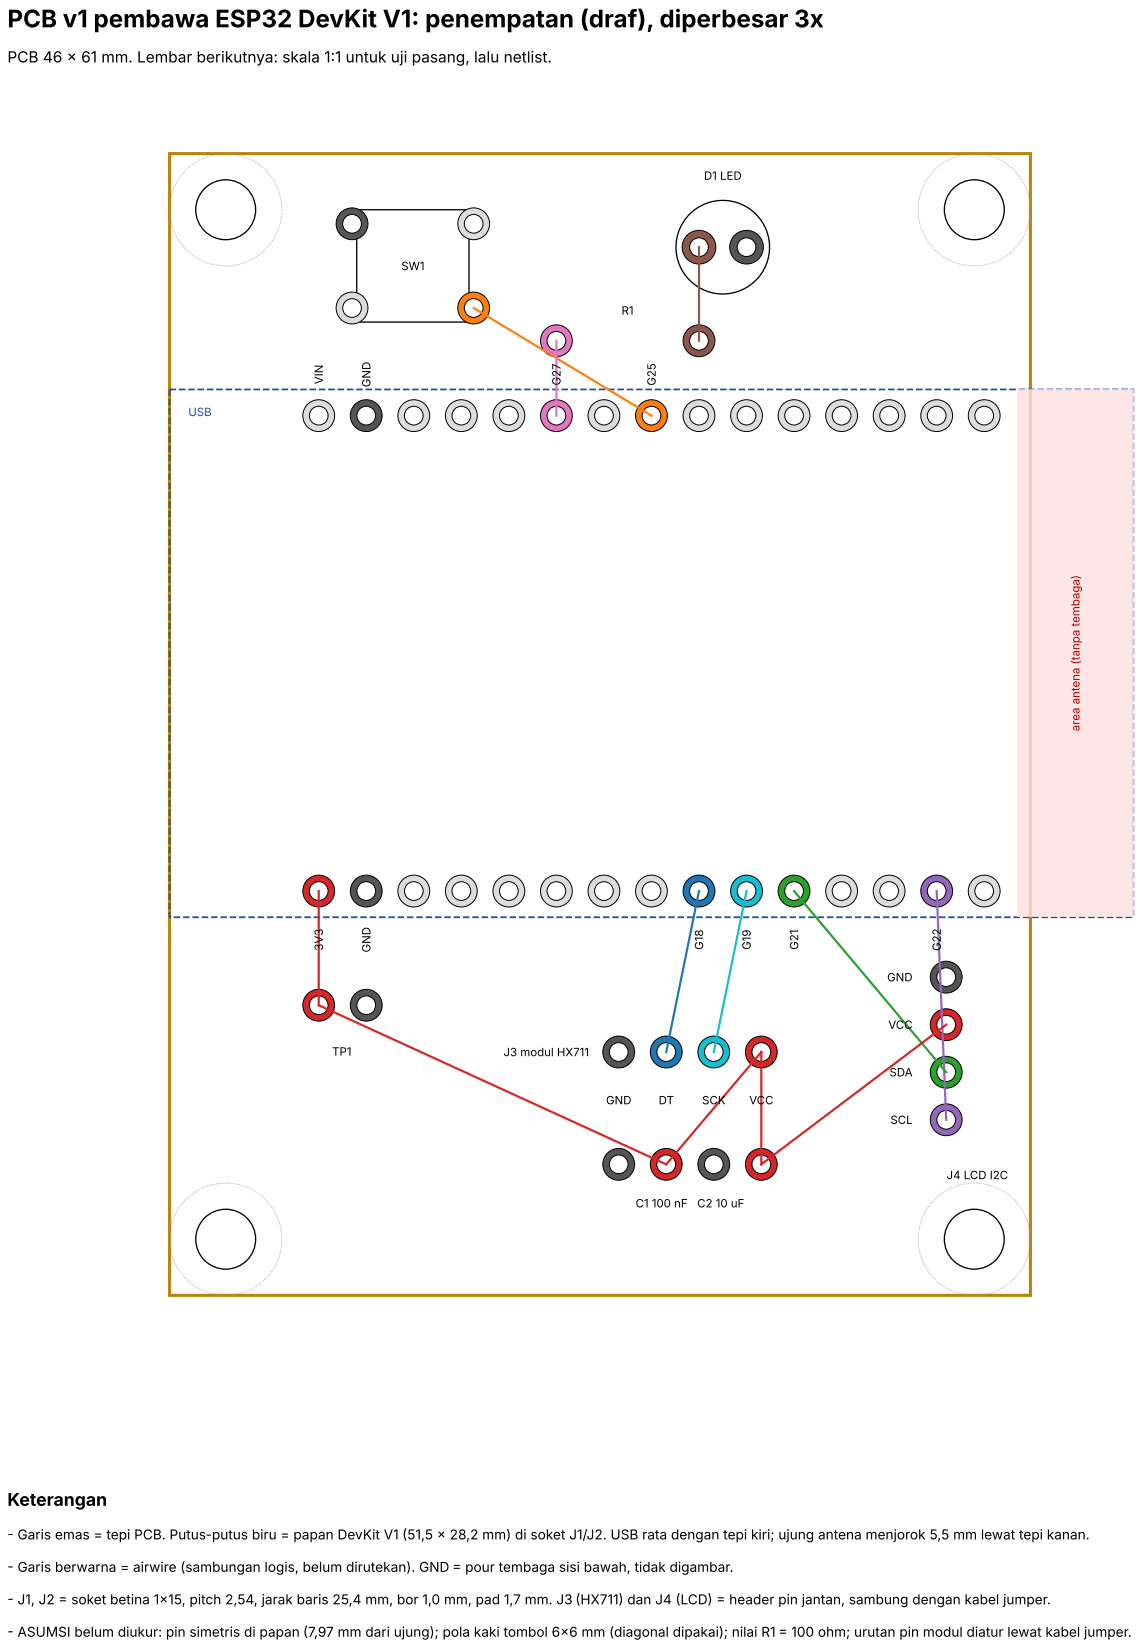
[picture p3: page 1]

PCB 46 x 61 mm. Lembar berikutnya: skala 1:1 untuk uji pasang, lalu netlist.

area antena (tanpa tembaga)

- Garis emas = tepi PCB. Putus-putus biru = papan DevKit V1 (51,5 x 28,2 mm) di soket J1/J2. USB rata dengan tepi kiri; ujung antena menjorok 5,5 mm lewat tepi kanan.

- Garis berwarna = airwire (sambungan logis, belum dirutekan). GND = pour tembaga sisi bawah, tidak digambar.

- J1, J2 = soket betina 1x15, pitch 2,54, jarak baris 25,4 mm, bor 1,0 mm, pad 1,7 mm. J3 (HX711) dan J4 (LCD) = header pin jantan, sambung dengan kabel jumper.

- ASUMSI belum diukur: pin simetris di papan (7,97 mm dari ujung); pola kaki tombol 6x6 mm (diagonal dipakai); nilai R1 = 100 ohm; urutan pin modul diatur lewat kabel jumper.

# Skala 1:1: untuk uji pasang (cetak 100%)

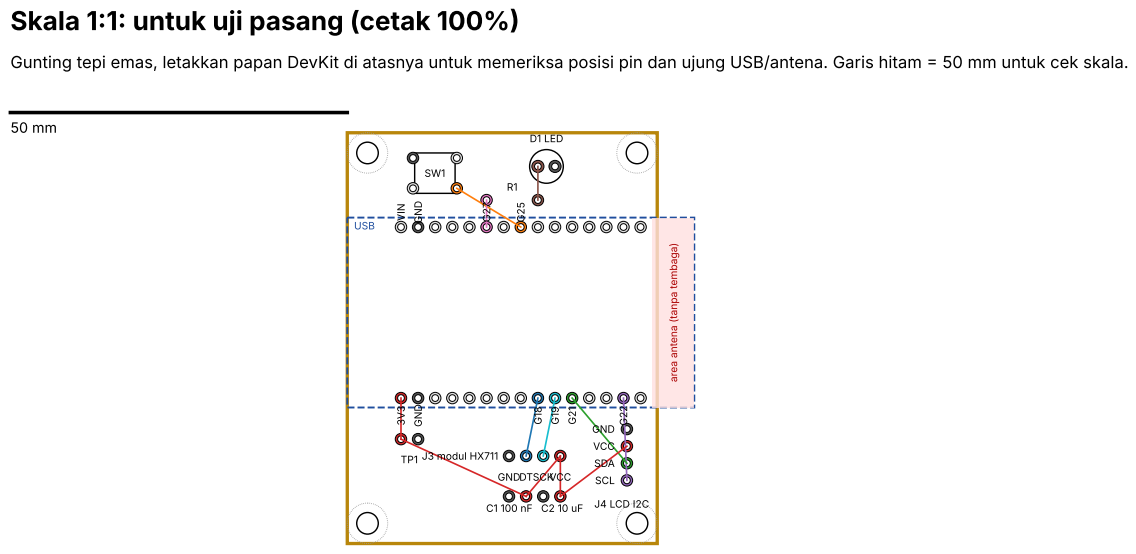
[picture p4: page 2]

Gunting tepi emas, letakkan papan DevKit di atasnya untuk memeriksa posisi pin dan ujung USB/antena. Garis hitam = 50 mm untuk cek skala.

area antena (tanpa tembaga)

# Netlist PCB v1

BTN | J1.8(GPIO25), SW1.4
LED_DRV | J1.10(GPIO27), R1.1
GND | J1.14(GND), J2.14(GND), SW1.1, D1.K, J3.1, J4.1, C1.2, C2.-, TP1.2
I2C_SCL | J2.2(GPIO22), J4.4
I2C_SDA | J2.5(GPIO21), J4.3
HX_SCK | J2.6(GPIO19), J3.3
HX_DT | J2.7(GPIO18), J3.2
+3V3 | J2.15(3V3), J3.4, J4.2, C1.1, C2.+, TP1.1
LED_A | R1.2, D1.A
