raden-ayu44/embedded-systems/(commit log)

2026-09-06 Add board verification sketch for ESP32
    This sketch verifies the board functionality by reporting chip information over serial and blinking the onboard LED without using delay in the loop.
2026-09-06 Add non-blocking LED blink example
    This sketch implements a non-blocking LED blink using millis() to manage timing without delay().
2026-09-06 Add bounce demo for button press handling
    This sketch demonstrates the LED toggling issue caused by button bounce, where multiple toggles occur from a single press.
    [bounce-demo.ino]
2026-09-06 Add debounced button functionality to control LED
    This sketch implements a debounced button that toggles an LED state when pressed, ensuring stable readings to avoid false toggles.
    [debounced-button.ino]
2026-09-06 Add walking light sketch with LED and button logic
    Implement walking light functionality with LED control and debounced button input.
2026-09-06 Add bidirectional light functionality
    Implement bidirectional light control with button debounce logic.
2026-09-06 Add board verification notes documentation
    Document the purpose and implementation details for board verification, including code snippets and explanations.
2026-09-06 Document debounced button logic and common mistakes
    Added detailed notes on debounced button implementation, explaining key variables and logic.
2026-09-07 Revise walking light notes with caveat and bug fixes
    Updated notes to include caveat about strapping pins and bugs encountered during development.
2026-09-07 Update bidirectional light notes with caveats and details
    Added caveat about strapping pins and clarified debounce logic.
2026-09-08 Add blocking dual blink example for LED control
    This sketch demonstrates a blocking approach to control two LEDs that blink at different rates using delay(). It serves as a reference for comparing with a non-blocking implementation.
2026-09-08 Add non-blocking dual blink sketch for two LEDs
    This sketch implements a non-blocking dual blink functionality for two LEDs, allowing them to blink independently at different rates without waiting on each other.
2026-09-08 Implement hardware timer with tick count display
    This code implements a hardware timer using the Arduino-ESP32 core 3.x API. It sets up a timer that increments a tick count every 100ms and prints the tick count to the Serial monitor.
2026-09-08 Document non-blocking dual blink implementation
    Added notes on implementing non-blocking dual blink functionality with independent LED states.
2026-09-08 Add hardware timer notes with code examples
    Added detailed notes on hardware timer usage, including code examples and explanations of key concepts such as ISR, volatile variables, and timer configuration.
2026-09-08 Update README with new video sections
    Added sections for Blocking Dual Blink, Non-blocking Dual Blink, and Hardware Timer with corresponding YouTube links.
2026-09-26 Remove vibrating motor from project scope
    Removed the vibrating motor from the proposal scope due to justification issues with the professor. Updated total budget and remaining funds accordingly.
2026-09-29 Revise proposal notes for Hand Grip Dynamometer
    Update version number and refine actuator feedback details in the proposal notes.
2026-10-06 Update project notes to version 29
    Updated project notes for Hand Grip Dynamometer to version 29, including changes to housing design, risk assessment, and logging details.
2026-10-07 Revise Desain Housing Load Cell to version 3
    Update document version from v1 to v3, revise design details and calibration setup.
2026-10-07 Upgrade document to Desain Housing Load Cell v4
    Updated document to version 4, added links to Fusion work instructions and parameters.
2026-10-07 Add calibration protocol for Hand Grip Dynamometer
    Document calibration protocol for Hand Grip Dynamometer including setup, tools, measurement steps, and safety precautions.
2026-10-09 Update work instructions for grip housing to v5 layout
2026-10-11 Koreksi dan update catatan proyek HGD
    Perbarui catatan proyek dengan koreksi dan penjelasan tambahan mengenai catu daya dan pin.
